sateefa2904/IGVC_Project/README.md

# IGVC_Project
Intelligent Ground Vehicle Competition: This project will be related to autonomous navigation using visual and sensory informations.

**Website:**
https://kopil46.github.io/IGVC_Website_2025/#hero
