sateefa2904/IGVC_Project/Poster_Final.pdf

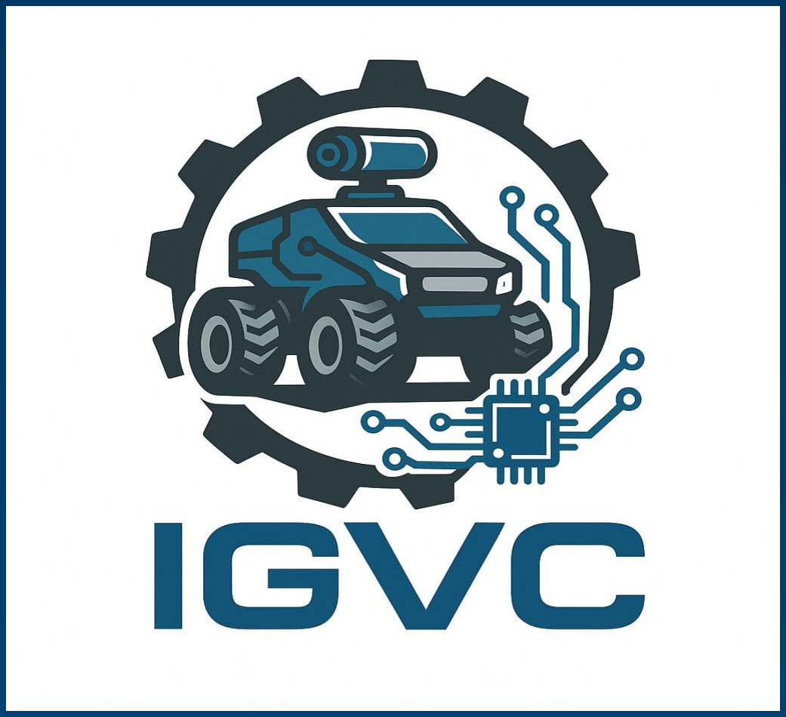
[picture p32: figure]
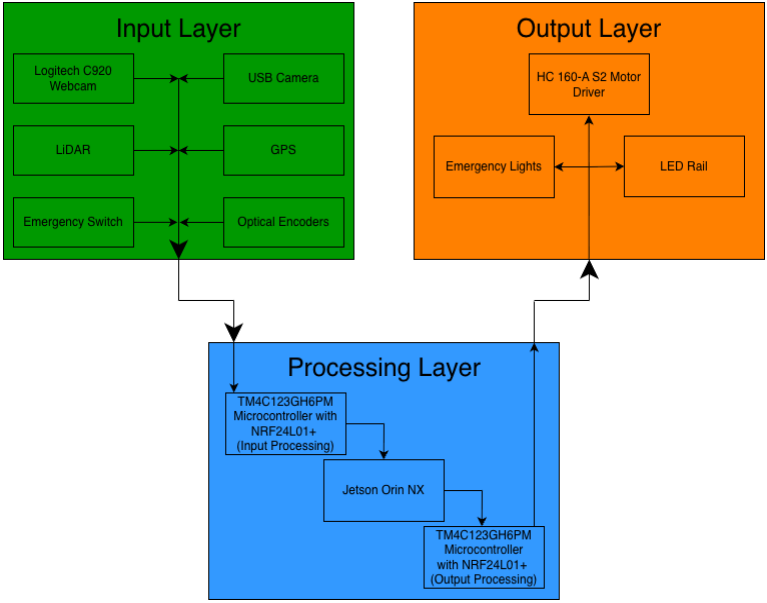
[picture p33: figure]
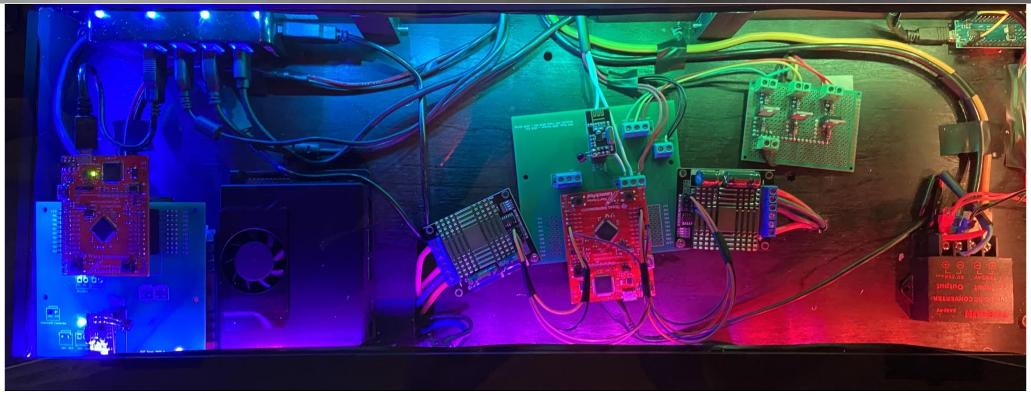
[picture p34: figure]
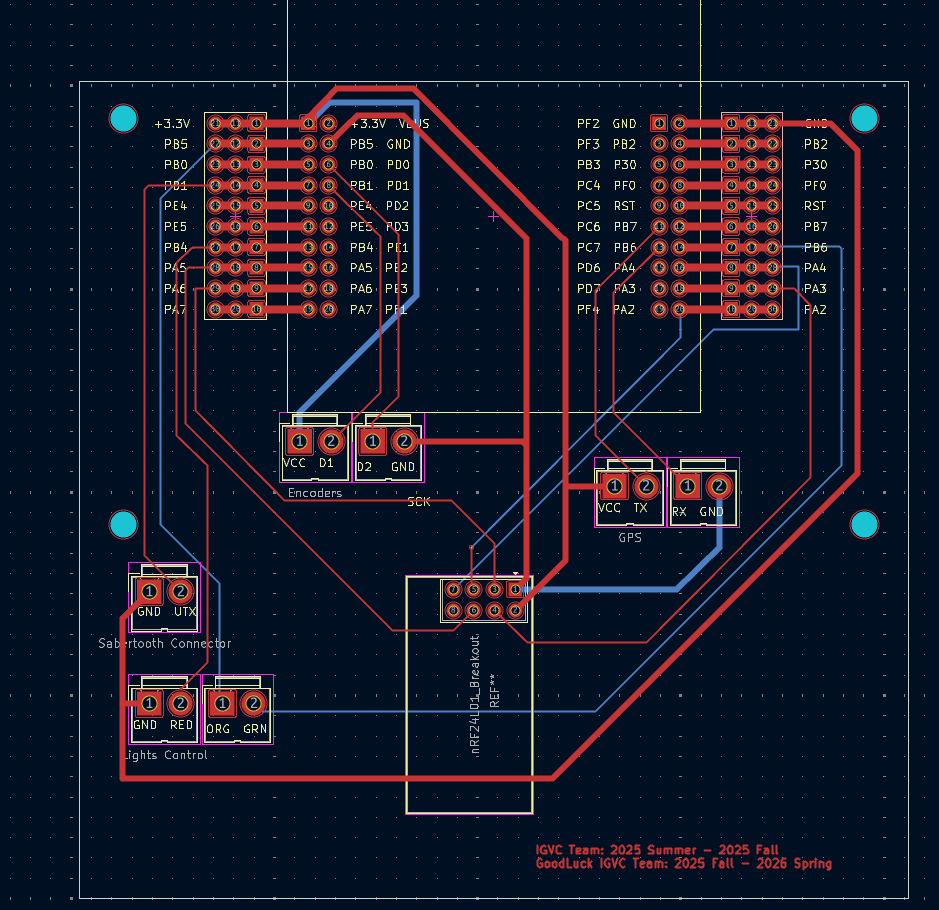
[picture p35: figure]

1. IGVC Official Rules & Design Guide.
2. Jetson Orin NX Technical Documentation.

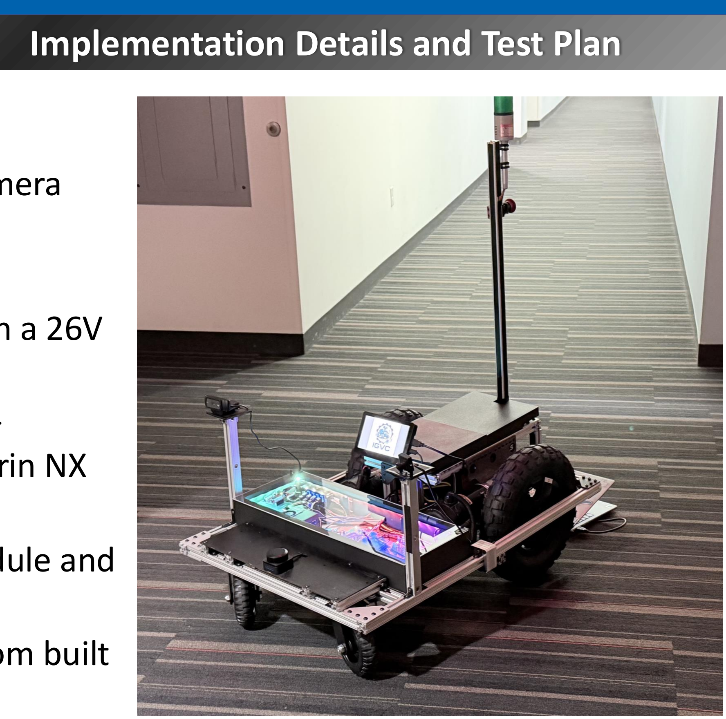
[picture p36: figure]
Implementation Details and Test Plan

3. TM4C123GH6PM & STM32F446RE MCU Datasheets

Sharma, K., Kowis, A., Van Lam, K., Tran, A., Biju, B., Rezwana, R.

# IGVC - Intelligent Ground Vehicle

### Input Layer

- LiDAR and Cameras collect real time information to set vehicle's overall direction and speed
- Optical Encoders and GPS refine the vehicle's position and movement for accurate navigation
- Emergency Stop Switch is used to cut power off to the motor in case of unexpected situations

### Processing Layer

- TM4C (input) takes in information from GPS and Encoders and passes it to the Jetson Orin
- The Jetson Orin NX processes data from LiDAR, camera vision, and TM4C to determine
the direction/speed of the motors and emergency light sequence.
- TM4C (output controller) receives these commands and sends exact signals to the motor drivers.

### Output Layer

- HC 160-A S2 motor drivers deliver the correct power and direction to the motors, moving the vehicle
- Emergency Lights are activated based on the state the machine is in, alerting anybody nearby.
- Lane detection pipeline tested with real-time two camera inputs.
- LiDAR obstacle detection validated during field tests.
- HC 160-A SC motor drivers for driving the motors with a 26V battery.
- Motor Controls with TM4C123GXL board. NRF24L01+ facilitating the communication between the Jetson Orin NX and Motor Drivers.
- Emergency-stop tested with wireless NRF24L01+ module and STM32F446RE.
- Indicator lights and Brake lights connected with Custom built PCB's using MOSFETs.

Human driving mistakes, labor shortages, and unsafe environments are major reasons why autonomous navigation is increasingly needed in real-world applications. Integrating autonomy in these fields will increase safety and efficiency all around. Modern processors can execute millions of instructions a second, leading to rapid decision making based on precise sensor readings. Our vehicle uses this capability to process real-time

information and calculate distance,

### speed, and obstacle measurements

to guide us through the unknown.

Conclusions and Future Work

QR Code To
Website or Paper
Goes Here

References

Background | Architectural Design

Key Requirements

## Implementation details and test plan

IGVC is an annual competition held to challenge university students to design and implement a fully autonomous ground vehicle. Our robot utilizes a Jetson Orin NX to perform real time decision making using camera vision and LiDAR detection. Using this, our vehicle can navigate through a series of obstacles in an outdoor environment. The system addresses real world applications in autonomous mobility and intelligent ground

vehicles.

October 2023

### Senior Design

1. S. McDermott, “Motor maniacs: Autonomous ground vehicle senior design project,”https://cse.uta.edu/senior-design/projects/motor-maniacs/, (https://cse.uta.edu/senior-design/projects/motor-maniacs/) 2025, university of Texas at Arlington, posted May 5, 2025. Accessed: 2025-09-19.
2. Intelligent Ground Vehicle Competition 2026 Rulebook, 2026, https://www.igvc.org.
3. Texas Instruments, “Tiva C Series TM4C123GH6PM Microcontroller Data Sheet,” https://www.ti.com/lit/ds/symlink/tm4c123gh6pm.pdf, accessed 2025-10-10.

The IGVC annual competition will take place in the summer of 2026. Our senior design team, working from Fall through Spring, will continue to develop the project, building upon the existing work and adding new functionalities to ensure we meet the competition's requirements. One exciting addition we plan to integrate is hydraulic systems, with the goal of enabling the vehicle to perform a hopping function.

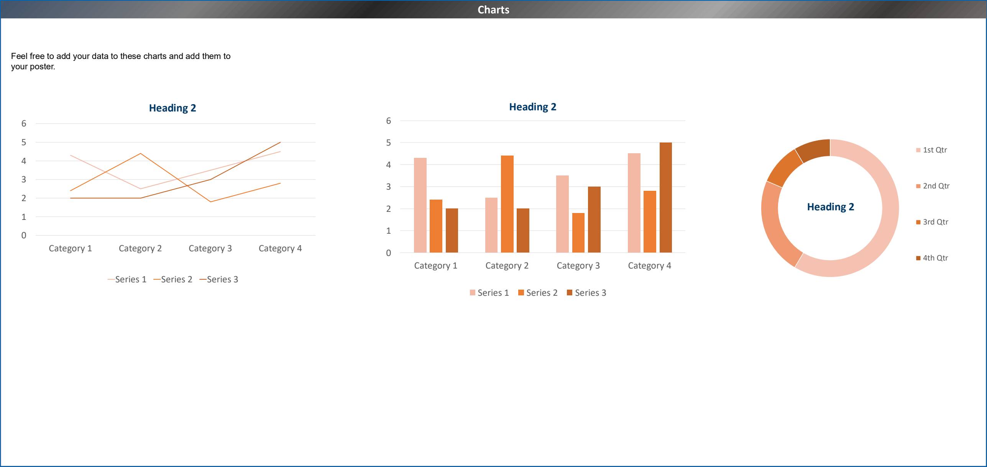
[picture p37: figure]
Charts; your poster.; 1st Qtr; 2nd Qtr; 3rd Qtr; 4th Qtr; Heading 2; Category 1; Category 2; Category 3; Category 4; Series 1; Series 2; Series 3

Feel free to add your data to these charts and add them to
