sateefa2904/IGVC_Project/Wire schematics and Block diagram/WireSchematic.drawio.png

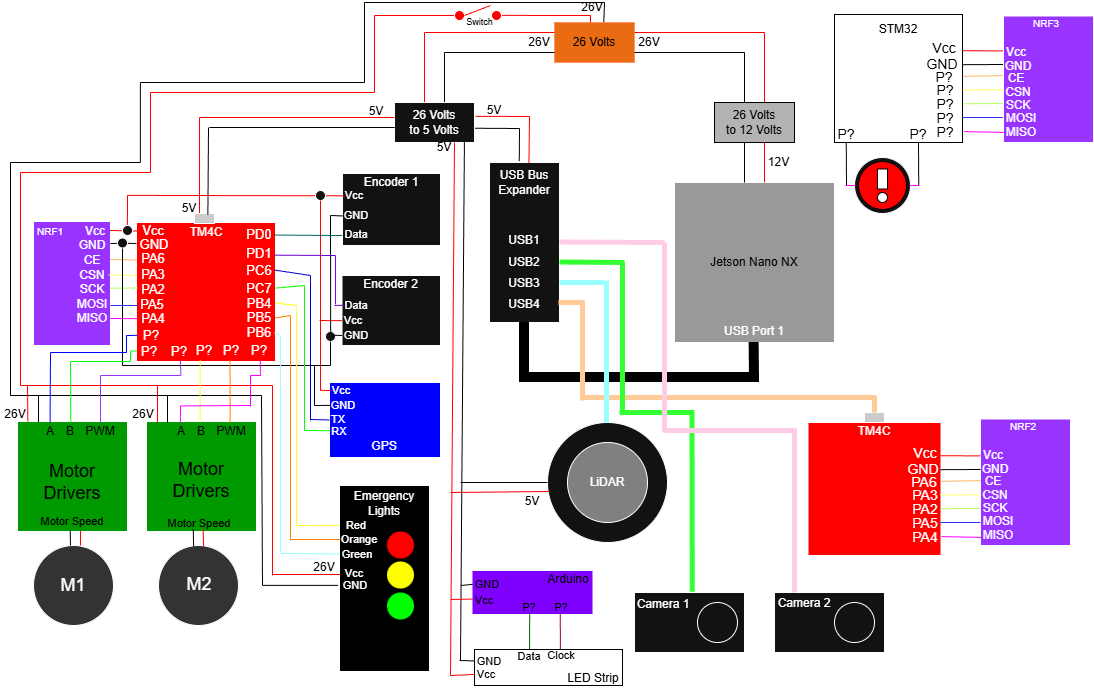
Wire schematics and Block diagram/WireSchematic.drawio.png
