sateefa2904/IGVC_Project/(list of files, cad)

Other CAD files:
3D Print files/LCD_hinges.f3d
3D Print files/battery_cap.f3d
3D Print files/encoder_mount.f3d
