sateefa2904/IGVC_Project/(commit log)

2025-12-07 Added Necessary Files
    [LCD_hinges.f3d, Tiva_Front_and_Back.kicad_pcb, battery_cap.f3d, encoder_mount.f3d]
2025-12-07 Enhance README with IGVC software documentation
    Added detailed documentation on the IGVC software components, including their working mechanisms and interactions. This includes sections on the Jetson camera processing, manual sender, motor controller receiver, auto/manual drive controller, GPS module, and encoder subsystem.
2026-03-22 Phase 2: Refactor camera_part3 for modular debugging and integrated control
2026-04-16 hybrid camera_part3 system? needs testing idk if this will work.
